Nosherwan12/Zone-Temperature-Fan-Control/docs/03_Electrical_Schematic.kicad_sch

## KiCad design docs/03_Electrical_Schematic.kicad_sch (2026-09-26)

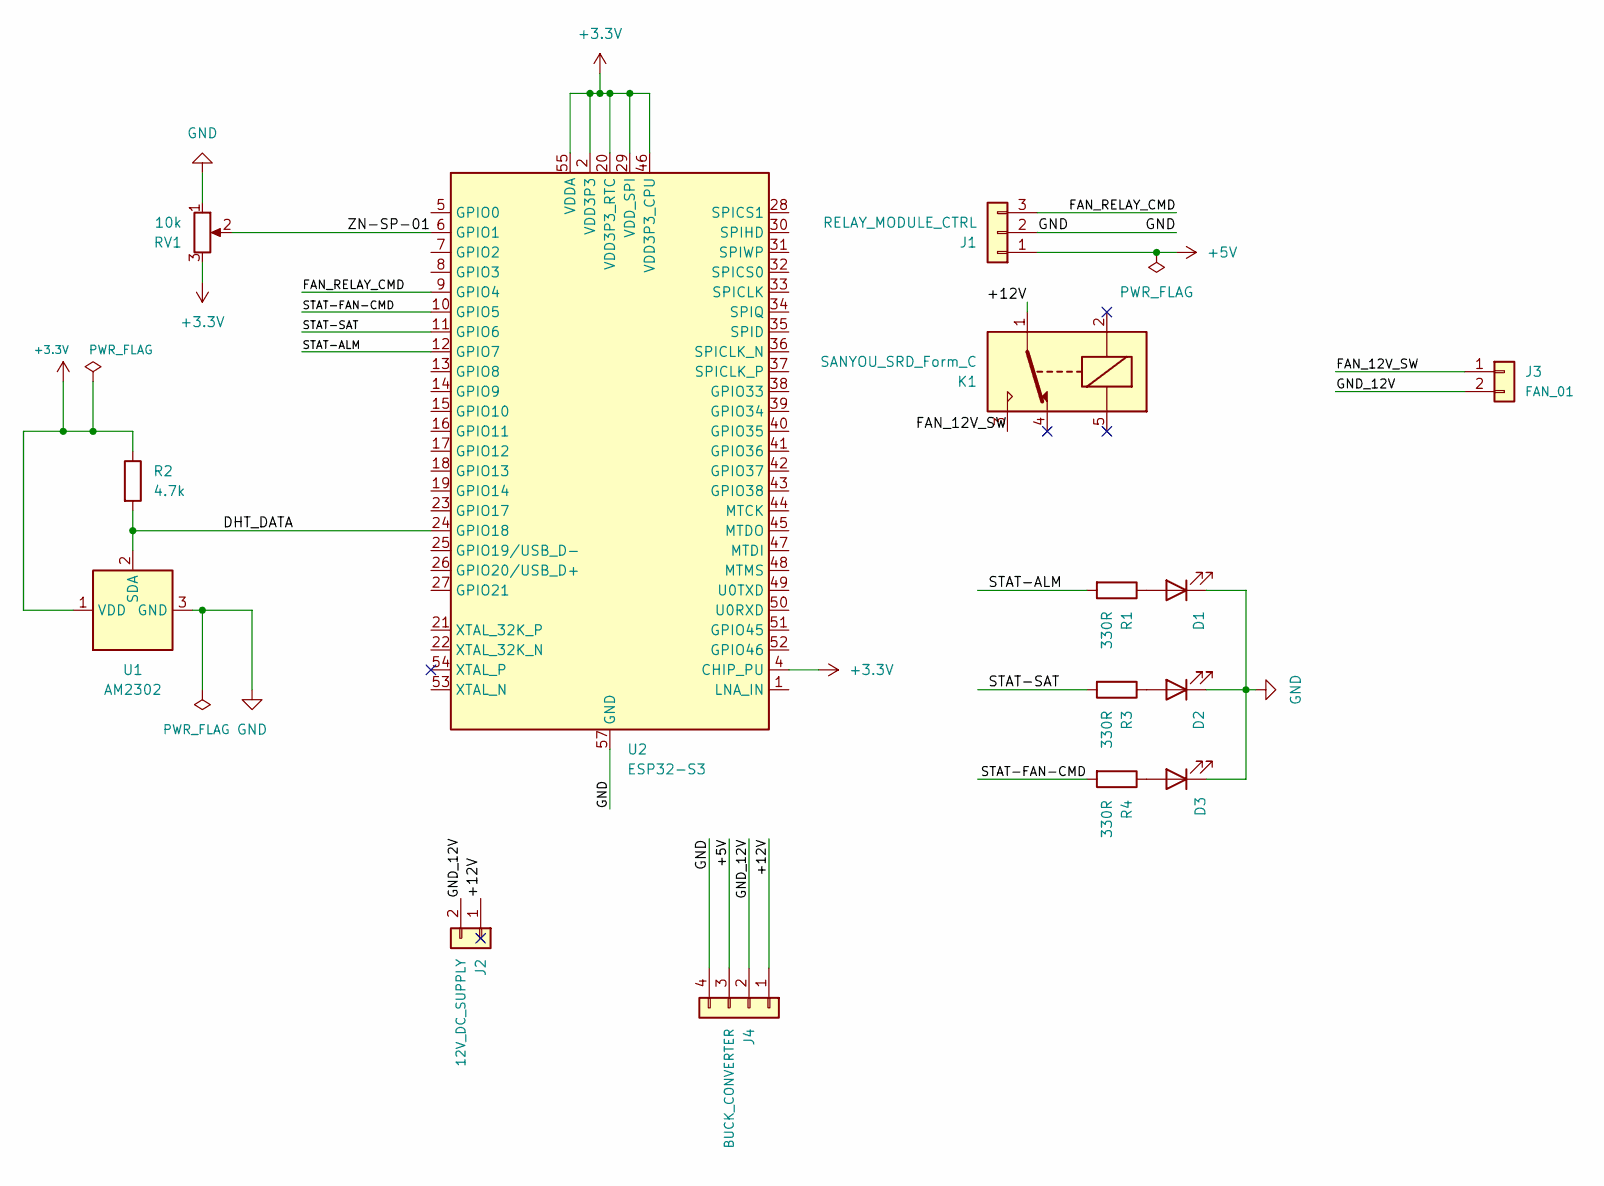
[picture p1: schematic 03_Electrical_Schematic.kicad_sch]

Parts:
D1, D2: LED
D3: GREEN
J1: RELAY_MODULE_CTRL
J2: 12V_DC_SUPPLY
J3: FAN_01
J4: BUCK_CONVERTER
K1: SANYOU_SRD_Form_C; Relay_SPDT_SANYOU_SRD_Series_Form_C
R1, R3, R4: 330R
R2: 4.7k
RV1: 10k
U1: AM2302; ASAIR_AM2302_P2.54mm_Vertical
U2: ESP32-S3; QFN-56-1EP_7x7mm_P0.4mm_EP4x4mm

Connections:
+3.3V: R2.1, RV1.3, U1.1 (VDD), U2.2 (VDD3P3), U2.3 (VDD3P3), U2.4 (CHIP_PU), U2.20 (VDD3P3_RTC), U2.29 (VDD_SPI), U2.46 (VDD3P3_CPU), U2.55 (VDDA), U2.56 (VDDA)
+5V: J1.1, J4.3
+12V: J2.1, J4.1, K1.1
DHT_DATA: R2.2, U1.2 (SDA), U2.24 (GPIO18)
FAN_12V_SW: J3.1, K1.3
FAN_RELAY_CMD: J1.3, U2.9 (GPIO4)
GND: D1.1 (K), D2.1 (K), D3.1 (K), J1.2, J4.4, RV1.1, U1.3 (GND), U1.4 (GND), U2.57 (GND)
GND_12V: J2.2, J3.2, J4.2
unnamed: D1.2 (A), R1.1
unnamed: D2.2 (A), R3.1
unnamed: D3.2 (A), R4.1
STAT-ALM: R1.2, U2.12 (GPIO7)
STAT-FAN-CMD: R4.2, U2.10 (GPIO5)
STAT-SAT: R3.2, U2.11 (GPIO6)
ZN-SP-01: RV1.2, U2.6 (GPIO1)
