Nosherwan12/Zone-Temperature-Fan-Control/docs/02_Sequence_of_Operations.docx

# ZONE TEMPERATURE AND FAN CONTROL UNIT

# SEQUENCE OF OPERATIONS

# 1. Purpose

The system provides simplified single-zone temperature monitoring and automatic fan control. Zone temperature and relative humidity are measured using a DHT22 sensor. An operator adjustable temperature setpoint is provided through a potentiometer. The controller uses the measured temperature and setpoint to determine the fan command, while status indicators provide visual indication of fan command, setpoint satisfaction, and high temperature deviation.

# 2. Temperature and Humidity Monitoring

The DHT22 sensor shall continuously provide zone temperature and relative humidity measurements to the controller. The controller shall acquire the sensor data at approximately 2-second intervals.

Zone temperature shall be used as the primary control variable for automatic fan operation and high-temperature deviation monitoring.

Zone relative humidity shall be monitored for informational purposes only and shall not affect the fan control sequence.

If a valid zone temperature reading is not available, the controller shall suspend normal fan control and force the fan command to OFF. The controller shall continue attempting to acquire a valid temperature reading. Normal temperature-based control shall resume when a valid sensor reading is restored.

# 3. Temperature Setpoint

The zone temperature setpoint shall be operator adjustable using a 10 kΩ potentiometer connected to the controller analog input.

The controller shall convert the potentiometer position to a temperature setpoint within the range of 15°C to 30°C.

The active setpoint shall be used as the reference value for automatic fan control and high-temperature deviation alarm evaluation.

The setpoint shall remain within the defined 15°C to 30°C operating range under normal operation.

# 4. Fan Control Sequence

The controller shall determine the fan command by comparing the measured zone temperature with the active temperature setpoint.

The fan shall be commanded ON when the zone temperature rises more than 0.5°C above the active setpoint.

The fan shall be commanded OFF when the zone temperature falls more than 0.5°C below the active setpoint.

When the zone temperature is within the ±0.5°C hysteresis band around the active setpoint, the controller shall retain the previous fan command state. No change to the fan command shall be made while the temperature remains within this band.

The fan shall be commanded OFF during system initialization and whenever a required control input is invalid or unavailable.

The fan command shall operate the connected fan through the relay output. The green status indicator shall indicate the active fan command and shall not be considered proof of physical fan operation.

Condition | Fan Command
Zone Temperature > Setpoint + 0.5°C | ON
Setpoint − 0.5°C ≤ Zone Temperature ≤ Setpoint + 0.5°C | Retain previous state
Zone Temperature < Setpoint − 0.5°C | OFF

# 5. High Temperature Deviation Alarm

The controller shall monitor the difference between the measured zone temperature and the active temperature setpoint.

A high temperature deviation alarm shall be activated when the zone temperature is more than 5°C above the active setpoint.

When the high temperature deviation alarm is active, the controller shall illuminate the red status indicator (STAT-ALM).

The high temperature deviation alarm shall be cleared when the zone temperature is below 5°C above the active setpoint.

The alarm shall indicate excessive temperature deviation from the active setpoint. It shall not be interpreted as a fan failure indication, as the system does not include physical fan status feedback.

If the zone temperature measurement is invalid or unavailable, the alarm shall be cleared and normal alarm evaluation shall be suspended until a valid temperature reading is restored.

# 6. Status Indicators

The controller shall provide visual status indication using three discrete LED indicators.

# 6.1 Fan Command Active

The green status indicator (STAT-FAN-CMD) shall be ON when the controller issues an ON command to the fan relay. The indicator shall be OFF when the controller issues an OFF command.

The indicator represents the controller's fan command only and shall not be considered confirmation of physical fan operation.

# 6.2 Setpoint Satisfied

The yellow status indicator (STAT-SAT) shall be ON when the measured zone temperature is within ±0.5°C of the active temperature setpoint.

The indicator shall be OFF when the temperature is outside this range or when the required control input is invalid.

# 6.3 High Temperature Alarm

The red status indicator (STAT-ALM) shall be ON when the high temperature deviation alarm is active. The indicator shall be OFF under normal temperature conditions.

# 6.4 Invalid Input Condition

When a required control input is invalid or unavailable, all three status indicators shall be turned OFF until valid control inputs are restored.

# 7. Fault Handling

The controller shall monitor the availability of the required temperature and setpoint inputs for execution of the automatic fan control sequence.

# 7.1 Temperature Sensor Fault

If the DHT22 sensor fails to initialize or a valid temperature reading cannot be obtained during operation, the controller shall suspend normal temperature-based fan control and force the fan command to OFF.

The controller shall continue attempting to obtain a valid temperature reading. No normal fan control decision shall be made using an invalid or unavailable temperature value.

# 7.2 Setpoint Input Fault

If the setpoint analog input fails to initialize or a valid setpoint reading cannot be obtained during operation, the controller shall suspend normal fan control and force the fan command to OFF.

The last valid setpoint shall not be used for continued automatic control when the current setpoint input is unavailable.

# 7.3 Status Indication During Fault

When a required control input is invalid or unavailable, the status indicators shall be turned OFF. The controller shall not indicate setpoint satisfaction or high-temperature deviation using invalid input data.

# 7.4 Fault Priority

A required input fault shall take priority over the normal fan control sequence. The fan shall remain commanded OFF until the required input is restored and valid data is available.

# 8. Fault Recovery

The controller shall continuously attempt to restore operation following a temperature sensor or setpoint input fault.

When a valid DHT22 temperature reading and a valid setpoint reading are restored, the controller shall resume the normal automatic fan control sequence.

For this prototype, a single valid reading is sufficient to resume normal control. No consecutive-valid-reading qualification period shall be required.

Upon recovery, the controller shall evaluate the current zone temperature against the active setpoint and determine the fan command according to the defined hysteresis control sequence.

The high temperature deviation alarm shall also resume evaluation using the restored valid temperature and setpoint inputs.

Status indicators shall resume normal operation based on the current valid system conditions.

# 9. System Limitations

This system is a simplified single-zone HVAC control prototype intended for demonstration of basic temperature monitoring, automatic fan control, status indication, and fault handling.

The following limitations apply:

1. The system controls a single temperature-controlled zone and does not implement multi-zone control.
2. The potentiometer provides a simulated operator-adjustable temperature setpoint and does not represent a building automation system operator interface.
3. The system provides fan command status only. No physical fan feedback, airflow proving, current sensing, or fan failure detection is implemented.
4. The system does not implement BACnet, Modbus, or other building automation communication protocols.
5. No production-level safety interlocks, redundant sensors, or independent safety controller are implemented.
6. The relay output provides switching control for the connected fan but does not provide variable-speed fan control.
7. The system is not intended to replace a certified commercial HVAC controller or a production building automation system.
8. The prototype's fault handling and control behavior are limited to the requirements defined in this Sequence of Operations.
