Nosherwan12/Zone-Temperature-Fan-Control/docs/04_Commissioning_Test_Sheet.xlsx

Sheet: Commissioning_Test
ZONE TEMPERATURE AND FAN CONTROL UNIT
COMMISSIONING / TEST SHEET
Project | Single-Zone HVAC Control Prototype
Controller | ESP32-S3
Document No. | 04
Revision | 1.0
Prepared By | Nosherwan Saeed
Commissioning Summary
COMMISSIONING SUMMARY
Total Tests | 7
Passed | 7
Pending | 0
Failed | 0
Overall Result | PASS
Remarks | Controller, sensor, setpoint, fan control, alarm, fault handling, recovery, relay, and 12 V fan operation verified.

Sheet: Test_Results
ZONE TEMPERATURE AND FAN CONTROL UNIT
COMMISSIONING TEST RESULTS
Project | Single-Zone HVAC Control Prototype
Controller | ESP32-S3
Document No. | 04
Revision | 1.0
Prepared By | Nosherwan Saeed
Test ID | Test Description | Test Condition / Input | Expected Result | Actual Result | Status
T-01 | Controller Startup | Power applied | Controller initializes with fan command OFF | Controller initialized successfully with fan command OFF. | PASS
T-02 | Temperature & Setpoint | Valid DHT22 reading and potentiometer input | Temperature is acquired and setpoint is generated within 15-30 degC | DHT22 returned valid temperature; potentiometer provided adjustable setpoint. | PASS
T-03 | Fan Control | Temperature crosses setpoint +/-0.5 degC thresholds | Fan command changes according to hysteresis logic | Fan control logic and relay response verified. | PASS
T-04 | High Temperature Alarm | Temperature > setpoint +5 degC | High-temperature alarm activates | Alarm logic implemented and red LED command generated when threshold is exceeded. | PASS
T-05 | Sensor Fault Handling | DHT22 disconnected | Fan is forced OFF and normal control is suspended | DHT22 read returned ESP_ERR_INVALID_SIZE; fan was forced OFF. | PASS
T-06 | Sensor Recovery | DHT22 reconnected | Valid reading restores normal control | Valid temperature/humidity readings resumed and normal control resumed. | PASS
T-07 | Fan and Relay Output | Fan command switched between ON/OFF states | Relay switches the 12 V fan ON/OFF according to the controller command | 12 V DC fan switched ON/OFF according to the controller command. | PASS
